Maximellerbach/AutonomousCar/docs/images/schema3.png

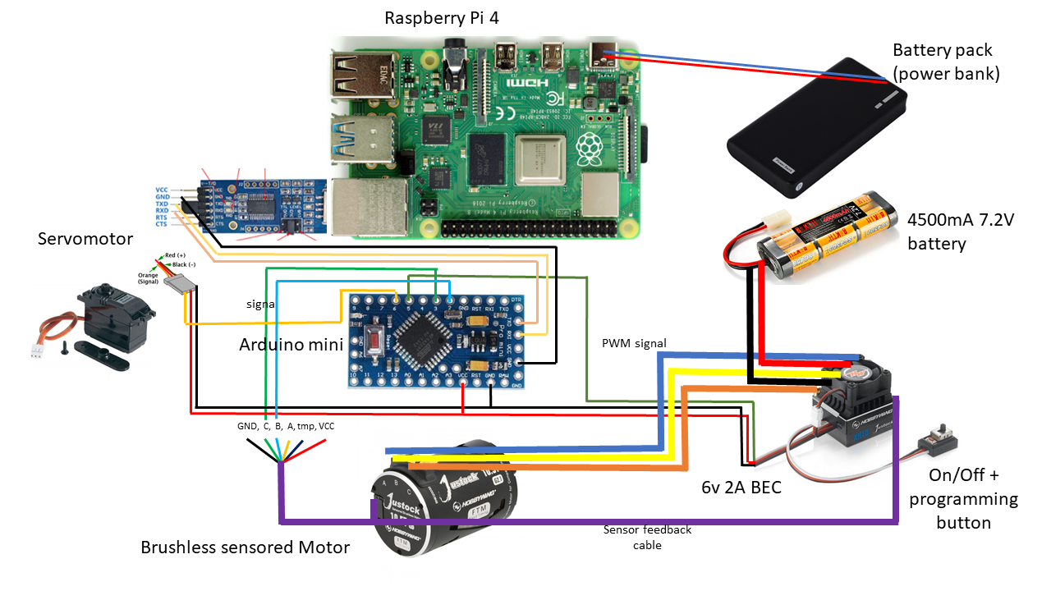
docs/images/schema3.png
