Maximellerbach/AutonomousCar/custom_modules/custom_modules/serial_command2.py

import threading
import time

import serial


def map_value(value, min, max, outmin, outmax):
    if value < min:
        value = min
    elif value > max:
        value = max

    return ((outmax - outmin) * (value - min)) / (max - min) + outmin


class control:
    """This classs send trhu serial port commands to an Arduino to pilot 2 motors using PWM and a servo motor."""

    def __init__(self, port):
        """
        Initialize the class. It does require a serial port name. it can be COMx where x is an interger on Windows.
        Or /dev/ttyXYZ where XYZ is a valid tty output for example /dev/ttyS2 or /dev/ttyUSB0
        """
        self.__ser = serial.Serial()
        self.__ser.port = port
        self.__ser.baudrate = 115200
        self.__ser.bytesize = serial.EIGHTBITS  # number of bits per bytes
        self.__ser.parity = serial.PARITY_NONE  # set parity check: no parity
        self.__ser.stopbits = serial.STOPBITS_ONE  # number of stop bits
        self.__ser.timeout = 0  # 0 = no timeout

        self.__sensor_rpm = 0  # init rpm of the sensor to 0
        self.__command = bytearray([255, 127, 127, 0])
        self.__isRuning = True
        self.__isOperation = False
        self.__boosting = False
        self.__toSend = []
        try:
            self.__ser.open()
            print("Serial port open")
            print(self.__ser.portstr)  # check which port was really used
            self.__ser.write(self.__command)
        except Exception as e:
            print("Error opening port: " + str(e))

        self.__wheel_to_meters = 0.20  # 1 wheel turn = 0.20 m
        self.__gear_ratio = 7  # 7 motor turn = 1 wheel turn

        self.__ignore_next = False
        self.__steering = 127
        self.__pwm = 127
        self.__last_received = time.time()

        self.__thread = threading.Thread(target=self.__runThreaded__)
        self.__thread.start()

        time.sleep(1)

    def stop(self):
        self.__isRuning = False
        self.__thread.join()
        if self.__ser.is_open:
            self.__ser.close()  # close port

    def __runThreaded__(self):
        while(True):
            self.__readRPM__()
            # if len(self.__toSend) > 0:
            #     cmd = self.__toSend[-1]
            #     self.__toSend = []
            #     self.__safeWrite__(cmd)

    def __safeWrite__(self, command):
        while self.__isOperation:
            pass
        self.__isOperation = True
        print("writing", command)
        self.__ser.write(command)
        self.__isOperation = False

    def __readRPM__(self):
        if self.__ser.in_waiting >= 1:
            while self.__isOperation:
                pass
            self.__isOperation = True
            try:
                out = self.__ser.readlines()[-1]

                if self.__ignore_next:
                    self.__ignore_next = False

                else:
                    # make sure that both end of lines are present
                    if out != "" and b'\r' in out and b'\n' in out:
                        res = int(out.decode())
                        if self.__pwm < 134 and self.__pwm > 120 and res > 27000:  # and res > 25000 and res < 29000 # no speed
                            self.__sensor_rpm = 0
                        else:
                            self.__sensor_rpm = (30000000 / res)
                        self.__last_received = time.time()
                    else:
                        self.__ignore_next = True

            except:
                pass

            finally:
                self.__isOperation = False

    def ChangeDirection(self, steering, min=-1, max=1):
        """Change steering."""
        self.__steering = int(map_value(steering, min, max, 0, 255))
        self.__command[1] = self.__steering
        self.__ser.write(self.__command)
        # self.__toSend.append(self.__command)

    def ChangePWM(self, pwm, min=-1, max=1):
        """Change motor speed."""
        self.__pwm = int(map_value(pwm, min, max, 0, 255))
        self.__command[2] = self.__pwm
        self.__ser.write(self.__command)
        # self.__toSend.append(self.__command)

    def ChangeAll(self, steering, pwm, min=[-1, -1], max=[1, 1]):
        """
        Change all the elements at the same time.

        steering is a byte from 0 to 255.
        PWM is a byte from 0 to 255.
        """
        self.__steering = int(map_value(steering, min[0], max[0], 0, 255))
        self.__pwm = int(map_value(pwm, min[1], max[1], 0, 255))

        self.__command[1] = self.__steering
        self.__command[2] = self.__pwm
        self.__ser.write(self.__command)
        # self.__toSend.append(self.__command)

    def GetRPM(self):
        return self.__sensor_rpm

    def GetWheelRPM(self):
        return self.__sensor_rpm / self.__gear_ratio

    def GetSpeed(self):
        return (self.__sensor_rpm / (self.__gear_ratio * 60)) * self.__wheel_to_meters

    def GetSensorLastReceived(self):
        return self.__last_received


def start_serial(port="/dev/ttyUSB0"):
    ser = control(port)
    return ser


if __name__ == "__main__":
    # motor test, servo test and rpm test
    ser = start_serial()
    # while True:
    #     ser.__readRPM__()
