Maximellerbach/AutonomousCar/custom_modules/custom_modules/predFunction.py

import math
import cv2
import matplotlib.pyplot as plt
import numpy as np
from tensorflow.keras.models import Model
from tqdm import tqdm

# TODO refactor those functions broke it by changing dataset


def average_data(data, window_size=10, sq_factor=1):
    averaged = []
    for i in range(window_size//2, len(data)-window_size//2):
        averaged.append(np.average(
            data[i-window_size//2: i+window_size//2], axis=-1)**sq_factor)

    data[window_size//2:-window_size//2] = averaged

    return data


def compare_pred(self, Dataset, dos, dt_range=(0, -1)):
    paths = Dataset.generator_load_dataset_sorted(dos)
    paths = paths[dt_range[0]:dt_range[1]]
    dts_len = len(paths)

    preds = []
    annotations = []
    for path in tqdm(paths):
        img, annotation = Dataset.load_img_and_annotation(path)
        annotations.append(annotation)

        inputs = [np.expand_dims(img/255, axis=0)]
        for index in self.input_components:
            inputs.append(np.expand_dims(annotations[index], axis=0))

        pred = self.model.predict(inputs)[0]
        preds.append(pred)

    preds = np.array(preds)
    annotations = np.arra(annotations)
    its = [i for i in range(dts_len)]

    for index in self.output_components:
        plt.plot(its, annotations[:, index], preds[:, index])

    plt.show()


def visualize_fe_output(self, img, input_size=(160, 120), waitkey=True):
    img = cv2.resize(img, input_size)
    fe_img = self.fe.predict(np.expand_dims(img, axis=0))[0]
    square_root = int(math.sqrt(fe_img.shape[-1]))+1

    square_img = np.zeros((square_root, square_root))
    for i in range(square_root):
        square_img[i, :] = fe_img[i*square_root:(i+1)*square_root]

    cv2.imshow('tot', square_img)
    if waitkey:
        cv2.waitKey(1)


def visualize_model_layer_filter(model, img, layer_index,
                                 input_size=(160, 120),
                                 layer_outputs=None, show=True, tmp_model=None):
    img = cv2.resize(img, input_size)
    if tmp_model is None:
        if layer_outputs is None:
            layer_output = model.layers[layer_index].output
        else:
            layer_output = layer_outputs[layer_index]
        tmp_model = Model(model.input, layer_output)

    activation = tmp_model.predict(np.expand_dims(img, axis=0))[0]
    activation = np.transpose(activation, (-1, 0, 1))

    n_filter = len(activation)
    columns = int(n_filter ** 0.5)+1

    final_image = np.zeros((columns*input_size[1], columns*input_size[0]))

    for i, filter_img in enumerate(activation):
        filter_img = cv2.resize(filter_img, input_size)
        final_image[
            (i//columns)*input_size[1]:(i//columns+1)*input_size[1],
            (i % columns)*input_size[0]:(i % columns+1)*input_size[0]
        ] = filter_img

    cv2.imshow(f'{layer_index}', final_image/np.max(final_image))
    if show:
        cv2.waitKey(0)

    return activation


def pred_img(self, Dataset, path, sleeptime):
    img, annotations = Dataset.load_img_and_annotation(path)
    to_pred_img = np.expand_dims(img/255, axis=0)

    inputs = [to_pred_img]
    for index in self.input_components:
        inputs.append(np.expand_dims())

    pred = self.model.predict(inputs)[0]

    '''
    c = np.copy(img)
    cv2.line(c,
             (img.shape[1]//2, img.shape[0]),
             (int(img.shape[1] / 2+average*30), img.shape[0]-50),
             color=[255, 0, 0], thickness=4)/255

    cv2.imshow('img', c)
    cv2.waitKey(sleeptime)
    '''


def load_frames(self, path, size=(160, 120), batch_len=32):
    """
    load a batch of frame from video
    """
    batch = []

    for _ in range(batch_len):
        _, frame = self.cap.read()
        frame = cv2.resize(frame, size)
        batch.append(frame)

    return batch


def after_training_test_pred(self, dos='C:\\Users\\maxim\\random_data\\4 trackmania A04\\', size=(160, 120), nimg_size=(5, 5), sleeptime=1):
    Dataset = dataset.Dataset(
        [dataset.direction_component, dataset.speed_component, dataset.time_component])
    for i in Dataset.load_dos(dos):
        img = cv2.imread(i)
        if self.load_speed:
            speed = Dataset.load_component_item(i, 1)
            pred_img(self, img, size, sleeptime,
                     speed=speed, nimg_size=nimg_size)


def speed_impact(self, dos, dt_range=(0, -1), sleeptime=33):

    Dataset = dataset.Dataset(
        [dataset.direction_component, dataset.speed_component, dataset.time_component])
    paths = Dataset.load_dos_sorted(dos, sort_component=-1)
    paths = paths[dt_range[0]:dt_range[1]]
    dts_len = len(paths)

    Y = np.array(Dataset.repeat_function(Dataset.load_annotation, paths))[:, 0]
    for it, path in enumerate(paths):
        img = cv2.imread(path)/255
        img_pred = np.expand_dims(img, axis=0)

        original_speed = Dataset.load_component_item(path, 1)
        original_pred = self.model.predict(
            [img_pred, np.expand_dims(original_speed, axis=0)])

        if self.load_speed[1]:
            original_pred, throttle_pred = original_pred
            original_pred = original_pred[0]
            throttle_pred = throttle_pred[0]
        real_lab = Y[it]

        c = img.copy()
        if self.load_speed[1]:
            cv2.line(c, (img.shape[1]//2, img.shape[0]),
                     (int(img.shape[1]/2+original_pred*30),
                      img.shape[0]-int(throttle_pred*50)),
                     color=[1, 0, 0], thickness=3)
        else:
            cv2.line(c, (img.shape[1]//2, img.shape[0]),
                     (int(img.shape[1]/2 + original_pred*30), img.shape[0]-50),
                     color=[0, 1, 1], thickness=3)

        cv2.line(c,
                 (img.shape[1]//2, img.shape[0]),
                 (int(img.shape[1] / 2 + real_lab*30), img.shape[0]-50),
                 color=[0, 0, 1], thickness=2)

        modified = compute_speed(self.model, img_pred,
                                 real_lab, accuracy=0.5, values_range=(0, 21))

        for it, pred in enumerate(modified):
            angle = pred[0][0][0]
            modified_throttle = pred[1][0][0]
            cv2.line(c, (img.shape[1]//2, img.shape[0]), (int(img.shape[1]/2+angle*30), img.shape[0]-int(
                modified_throttle*50)), color=[0.5+(it)/(2*len(modified)), (it)/len(modified), 0], thickness=1)

        cv2.imshow('img', img)
        cv2.imshow('angles', c)
        cv2.waitKey(sleeptime)
    cv2.destroyAllWindows()


def compute_speed(model, img_pred, original_pred, accuracy=1, values_range=(0, 20), show=True):
    speeds = np.array(range(values_range[0], int(
        values_range[1]*accuracy)))/accuracy
    modified = []
    for speed in speeds:
        modified.append(model.predict(
            [img_pred, np.expand_dims(speed, axis=0)]))

    return modified


def process_trajectory_error():  # TODO: evaluate long term precision of the model
    return
