Maximellerbach/AutonomousCar/(commit log)

2019-03-09 new repo
    [voiture.xlsx]
2019-10-22 big update, new models, new training techniques...
    [voiture.xlsx]
2019-12-28 added recurrence training + bug fixing
    [architectures.py, datagenerator.py]
2020-01-19 added frame matching program
2020-03-11 added track estimation, will become usefull in the future
2020-03-11 tweaked estimator, will be adding speed estimation soon with circuit matching
2020-03-13 updated architecture and track estimation, waiting for speed estimation
2020-03-16 added features to track estimation
2020-04-30 code refactoring + disabled flip to dataaugmentation
    [architectures.py, datagenerator.py, pred_function.py]
2020-05-10 trying to add throttle
2020-05-12 added sample weights into the generator !
2020-05-20 new model/ new track estimation
2020-05-26 adapted everything with new modular Dataset class, will be used for throttle
2020-05-27 adding track creation tool
2020-05-29 added z axis generation
2020-06-01 moved track generation program
2020-06-02 new model on random generated circuits
2020-06-07 added throttle in training
2020-06-08 trained with throttle !
2020-06-21 code refactoring, speed sensor is now working !
2020-07-16 rnn training still not working, has to be something with input/output data
    [architectures.py, datagenerator.py, pred_function.py]
2020-07-17 added kalman filtering + new sensor objects
2020-07-31 code refactoring, fixed some bugs, generate function still not working
    [datagenerator.py, dataset_json.py]
2020-08-01 fixed json dataset and autolib
    [datagenerator.py, dataset_json.py]
2020-08-16 repo refactoring
    [voiture.xlsx]
2020-08-23 started refactoring on track estimation
2020-09-16 few bug fixes and a new model
    [architectures.py, datagenerator.py, dataset_json.py]
2020-09-19 new model on new circuit
2020-10-05 need to see why reverse motor doesn't mean negative speed
    [motor.py]
2020-10-06 need to refactor sensor, seing some strange stuff..
2020-12-20 hardware update ! new car, new arduino code and new serial_command
2020-12-29 code refactoring, fixing some stuff
    [ArduinoControl2.ino, architectures.py, datagenerator.py]
2020-12-30 added pid steering for trajectory planning
2021-03-13 some fixes and new stuff
    [visual_interface.py]
2021-03-20 added a way to viz circuits from coordinates
2021-09-10 trying to disable some things that could block tflite
    trying with regular tf
    trying a pre-compiled version of tflite
    added back a tflite model
    now using tflite_runtime for tflite
    reverting changes, no tflite :(
    big file formating
    [PID.py, adjust_training.py, angle_turn.py, architectures.py]
2021-09-10 trying some stuff to make it work using multiple threads
2021-09-11 messing up with the camera frame rate
2021-09-11 trying threaded camera
2021-09-11 trying to use 4 threads with tflite
2021-10-09 added a threaded data saver
2021-10-09 fixed controller not disconnecting
    [controller.py, memory.py]
2021-10-10 fixed the add_shadow function
    [imaugm.py]
2021-10-22 fixed a bug and trying to train with higher batchsizes
    [architectures.py, pred_function.py]
2021-10-24 changed the throttle value
2021-11-10 added some debugging for rpm sensor
2021-12-30 revert some changes on the archi
    [architectures.py]
